Secant1006/OpenFlops-Plus/README.md

# OpenFlops-Plus
Enhanced version of open-source gotek

[OpenFlops](https://github.com/SukkoPera/OpenFlops)

[FlashFloppy](https://github.com/keirf/flashfloppy)
