Secant1006/OpenFlops-Plus/Enclosure/Bottom.sldprt

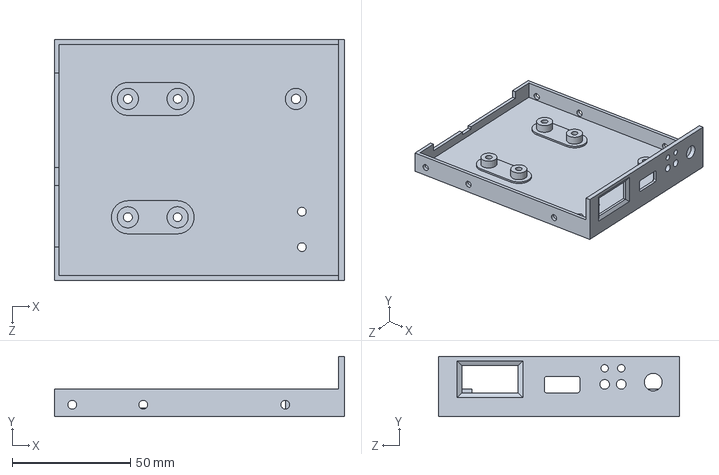
[picture p1: CAD file, 2026-06-17]
Enclosure/Bottom.sldprt
122.5 x 25.4 x 101.6 mm
