Secant1006/OpenFlops-Plus/Enclosure/Top.sldprt

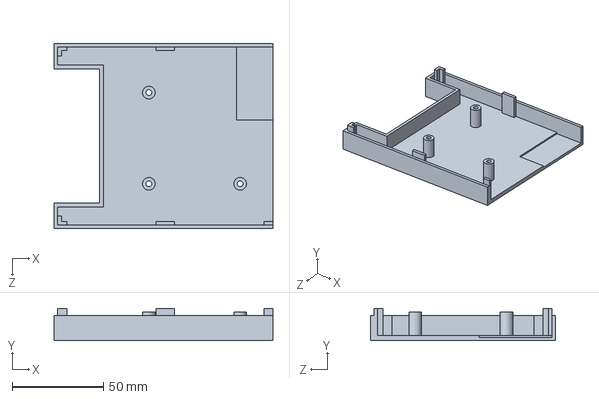
[picture p2: CAD file, 2026-06-17]
Enclosure/Top.sldprt
120.0 x 17.8 x 101.6 mm
