Secant1006/OpenFlops-Plus/Enclosure/Screen Bracket.sldprt

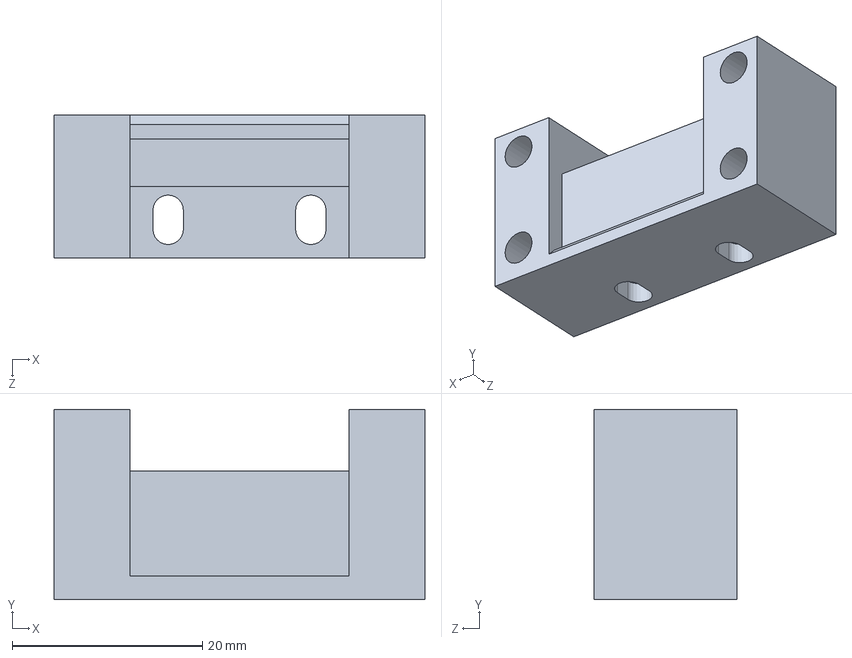
[picture p3: CAD file, 2026-06-17]
Enclosure/Screen Bracket.sldprt
39.0 x 20.0 x 15.0 mm
