Secant1006/OpenFlops-Plus/OpenFlops Plus.kicad_pcb

## KiCad design OpenFlops Plus.kicad_pcb (2026-06-24)

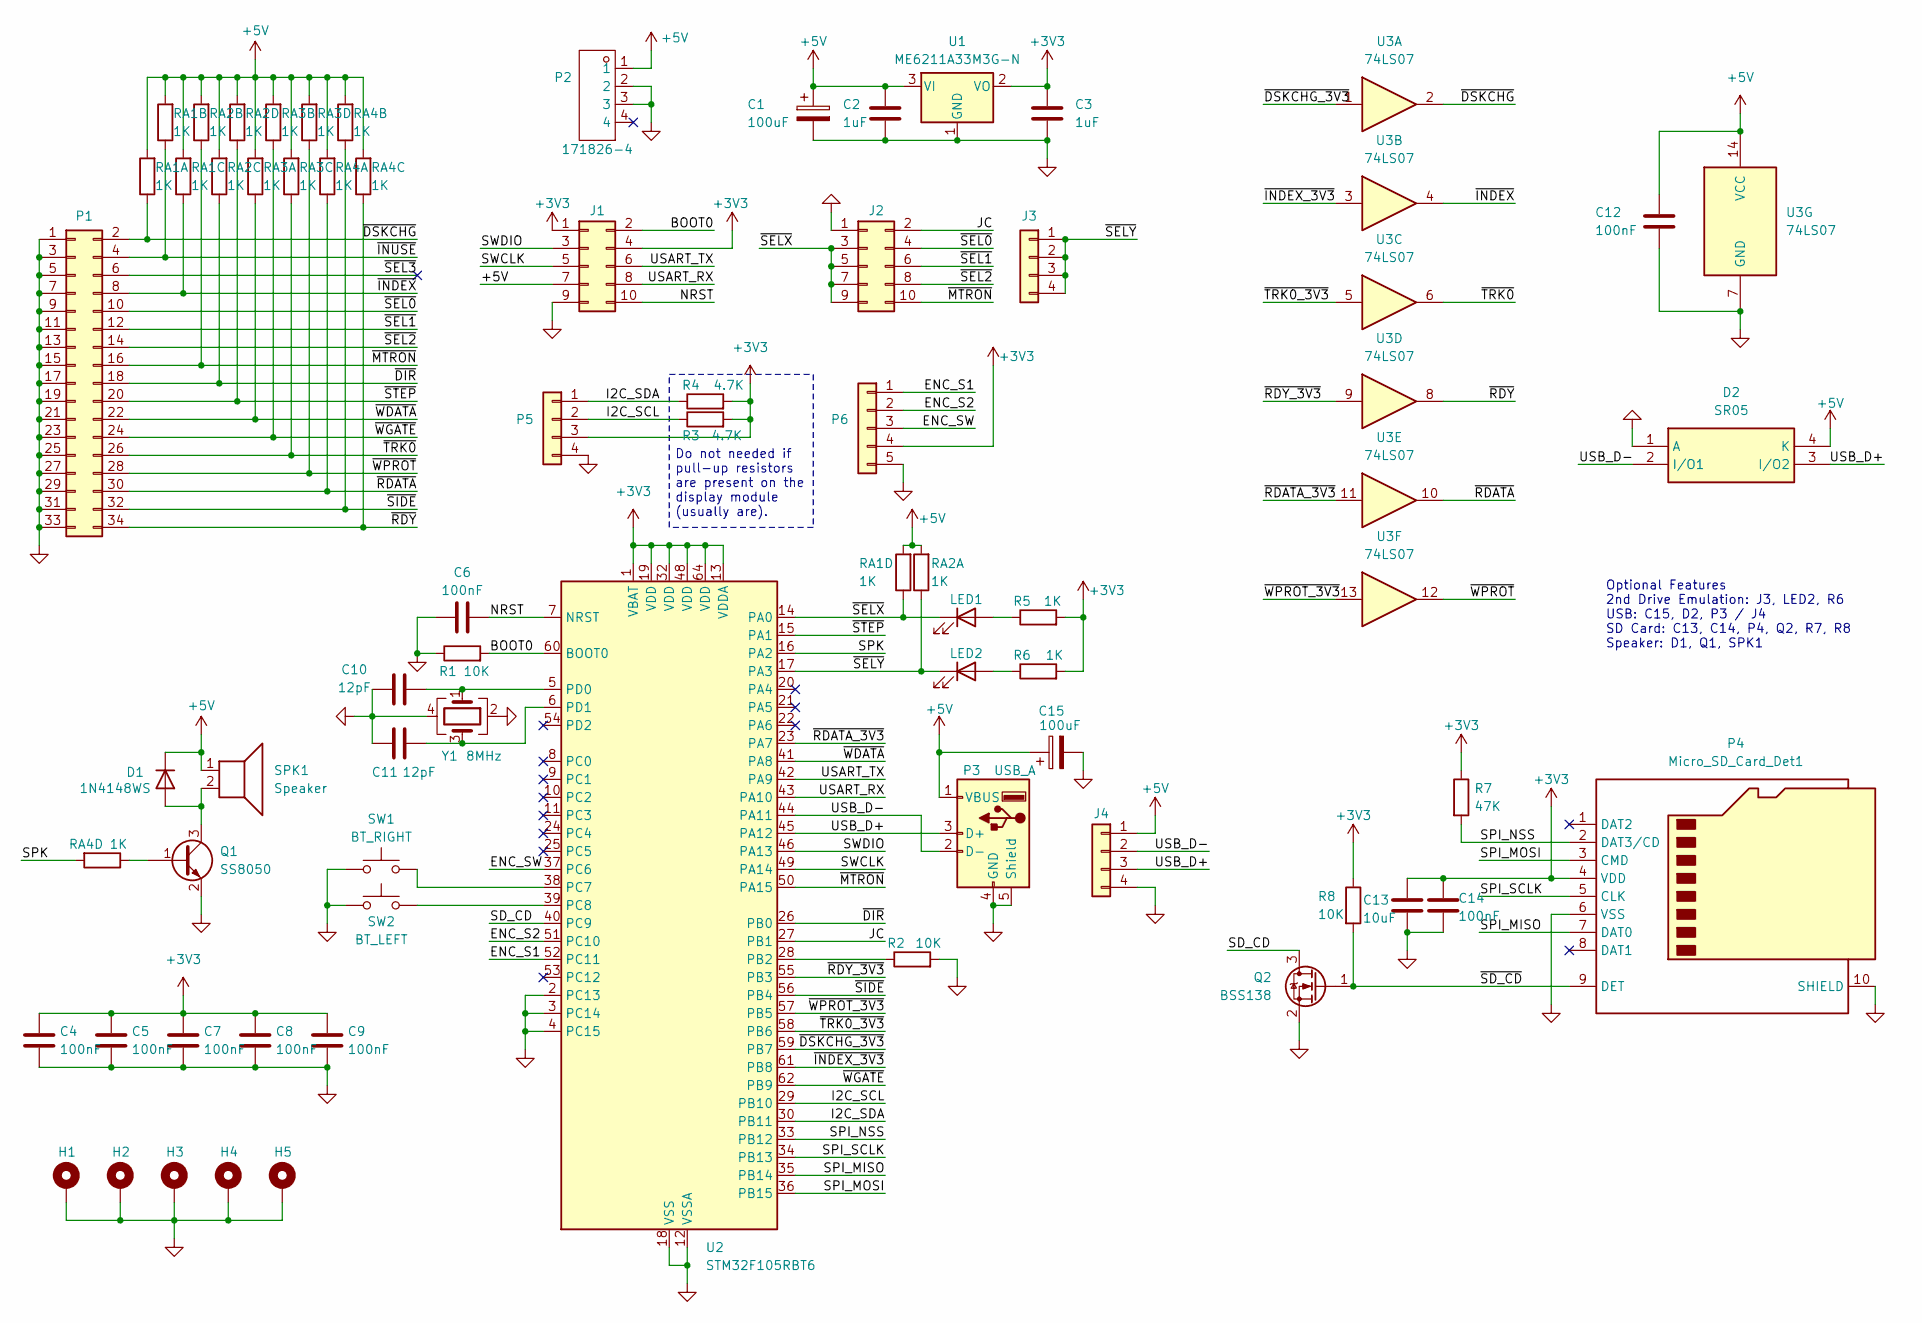
[picture p4: schematic OpenFlops Plus.kicad_sch]

Parts:
C1, C15: 100uF; CP_Radial_D6.3mm_P2.50mm
C2, C3: 1uF; C_0603_1608Metric
C4, C5, C6, C7, C8, C9, C12, C14: 100nF; C_0603_1608Metric
C10, C11: 12pF; C_0603_1608Metric
C13: 10uF; C_0805_2012Metric
D1: 1N4148WS; D_SOD-323
D2: SR05; SOT-143; Manufacturer_Part_Number SR05.TCT; Mouser Part Number 947-SR05.TCT
H1, H2, H3, H4, H5: MountingHole_Pad; MountingHole_3.2mm_M3_Pad
J1, J2: Conn_02x05_Odd_Even; PinHeader_2x05_P2.54mm_Vertical
J3, J4: Conn_01x04; PinHeader_1x04_P2.54mm_Vertical
LED1, LED2: LED; LED_D3.0mm
P1: Conn_02x17_Odd_Even; PinHeader_2x17_P2.54mm_Vertical
P2: 171826-4; CONN-TH_4P-P2.50_171826-4; Manufacturer Part 171826-4; LCSC Part Name 1x4P 间距:2.5mm 弯插
P3: USB_A; USB_A_Molex_67643_Horizontal
P4: Micro_SD_Card_Det1; TF-SMD_XKTF-015-N
P5: Conn_01x04; PinHeader_1x04_P2.54mm_Vertical
P6: Conn_01x05; PinHeader_1x05_P2.54mm_Vertical
Q1: SS8050; SOT-23
Q2: BSS138; SOT-23
R1, R2, R8: 10K; R_0603_1608Metric
R3, R4: 4.7K; R_0603_1608Metric
R5, R6: 1K; R_0603_1608Metric
R7: 47K; R_0603_1608Metric
RA1, RA2, RA3, RA4: 1K; R_Array_Convex_4x0603
SPK1: Speaker; Buzzer_12x9.5RM7.6
SW1: BT_RIGHT; SW_Tactile_SKHH_Angled
SW2: BT_LEFT; SW_Tactile_SKHH_Angled
U1: ME6211A33M3G-N; SOT-23-3
U2: STM32F105RBT6; LQFP-64_10x10mm_P0.5mm
U3: 74LS07; SOIC-14_3.9x8.7mm_P1.27mm
Y1: 8MHz; Crystal_SMD_3225-4Pin_3.2x2.5mm

Connections:
+3V3: C3.1, C4.1, C5.1, C7.1, C8.1, C9.1, C13.1, C14.1, J1.1, J1.4, P4.4 (VDD), P5.3, P6.4, R3.2, R4.2, R5.2, R6.2, R7.1, R8.1, U1.2 (VO), U2.1 (VBAT), U2.13 (VDDA), U2.19 (VDD), U2.32 (VDD), U2.48 (VDD), U2.64 (VDD)
+5V: C1.1, C2.1, C12.1, C15.1, D1.1 (K), D2.4 (K), J1.7, J4.1, P2.1, P3.1 (VBUS), RA1.5 (R4.2), RA1.6 (R3.2), RA1.7 (R2.2), RA1.8 (R1.2), RA2.5 (R4.2), RA2.6 (R3.2), RA2.7 (R2.2), RA2.8 (R1.2), RA3.5 (R4.2), RA3.6 (R3.2), RA3.7 (R2.2), RA3.8 (R1.2), RA4.6 (R3.2), RA4.7 (R2.2), RA4.8 (R1.2), SPK1.1, U1.3 (VI), U3.14 (VCC)
/BOOT0: J1.2, R1.2, U2.60 (BOOT0)
/ENC_S1: P6.1, U2.52 (PC11)
/ENC_S2: P6.2, U2.51 (PC10)
/ENC_SW: P6.3, U2.37 (PC6)
/I2C_SCL: P5.2, R3.1, U2.29 (PB10)
/I2C_SDA: P5.1, R4.1, U2.30 (PB11)
/JC: J2.2, U2.27 (PB1)
/NRST: C6.2, J1.10, U2.7 (NRST)
/SD_CD: Q2.3 (D), U2.40 (PC9)
/SPI_MISO: P4.7 (DAT0), U2.35 (PB14)
/SPI_MOSI: P4.3 (CMD), U2.36 (PB15)
/SPI_NSS: P4.2 (DAT3/CD), R7.2, U2.33 (PB12)
/SPI_SCLK: P4.5 (CLK), U2.34 (PB13)
/SPK: RA4.5 (R4.2), U2.16 (PA2)
/SWCLK: J1.5, U2.49 (PA14)
/SWDIO: J1.3, U2.46 (PA13)
/USART_RX: J1.8, U2.43 (PA10)
/USART_TX: J1.6, U2.42 (PA9)
/USB_D+: D2.3 (I/O2), J4.3, P3.3 (D+), U2.45 (PA12)
/USB_D-: D2.2 (I/O1), J4.2, P3.2 (D-), U2.44 (PA11)
/~DIR: P1.18, RA2.3 (R3.1), U2.26 (PB0)
/~DSKCHG_3V3: U2.59 (PB7), U3.1
/~DSKCHG: P1.2, RA1.1 (R1.1), U3.2
/~INDEX_3V3: U2.61 (PB8), U3.3
/~INDEX: P1.8, RA1.3 (R3.1), U3.4
/~INUSE: P1.4, RA1.2 (R2.1)
/~MTRON: J2.10, P1.16, RA2.2 (R2.1), U2.50 (PA15)
/~RDATA_3V3: U2.23 (PA7), U3.11
/~RDATA: P1.30, RA4.1 (R1.1), U3.10
/~RDY_3V3: U2.55 (PB3), U3.9
/~RDY: P1.34, RA4.3 (R3.1), U3.8
/~SD_CD: P4.9 (DET), Q2.1 (G), R8.2
/~SEL0: J2.4, P1.10
/~SEL1: J2.6, P1.12
/~SEL2: J2.8, P1.14
/~SEL3: P1.6
/~SELX: J2.3, J2.5, J2.7, J2.9, LED1.1 (K), RA1.4 (R4.1), U2.14 (PA0)
/~SELY: J3.1, J3.2, J3.3, J3.4, LED2.1 (K), RA2.1 (R1.1), U2.17 (PA3)
/~SIDE: P1.32, RA4.2 (R2.1), U2.56 (PB4)
/~STEP: P1.20, RA2.4 (R4.1), U2.15 (PA1)
/~TRK0_3V3: U2.58 (PB6), U3.5
/~TRK0: P1.26, RA3.3 (R3.1), U3.6
/~WDATA: P1.22, RA3.1 (R1.1), U2.41 (PA8)
/~WGATE: P1.24, RA3.2 (R2.1), U2.62 (PB9)
/~WPROT_3V3: U2.57 (PB5), U3.13
/~WPROT: P1.28, RA3.4 (R4.1), U3.12
GND: C1.2, C2.2, C3.2, C4.2, C5.2, C6.1, C7.2, C8.2, C9.2, C10.1, C11.1, C12.2, C13.2, C14.2, C15.2, D2.1 (A), H1.1, H2.1, H3.1, H4.1, H5.1, J1.9, J2.1, J4.4, P1.1, P1.3, P1.5, P1.7, P1.9, P1.11, P1.13, P1.15, P1.17, P1.19, P1.21, P1.23, P1.25, P1.27, P1.29, P1.31, P1.33, P2.2, P2.3, P3.4 (GND), P3.5 (Shield), P4.6 (VSS), P4.10 (SHIELD), P4.11, P4.12, P4.13, P5.4, P6.5, Q1.2 (E), Q2.2 (S), R1.1, R2.2, SW1.2, SW2.1, U1.1 (GND), U2.2 (PC13), U2.3 (PC14), U2.4 (PC15), U2.12 (VSSA), U2.18 (VSS), U2.31 (VSS), U2.47 (VSS), U2.63 (VSS), U3.7 (GND), Y1.2, Y1.4
unnamed: D1.2 (A), Q1.3 (C), SPK1.2
unnamed: LED1.2 (A), R5.1
unnamed: LED2.2 (A), R6.1
unnamed: Q1.1 (B), RA4.4 (R4.1)
unnamed: R2.1, U2.28 (PB2)
unnamed: SW1.1, U2.38 (PC7)
unnamed: SW2.2, U2.39 (PC8)
unnamed: C10.2, U2.5 (PD0), Y1.1
unnamed: C11.2, U2.6 (PD1), Y1.3

Notes on the sheet:
Do not needed if pull-up resistors are present on the display module (usually are).
Optional Features 2nd Drive Emulation: J3, LED2, R6 USB: C15, D2, P3 / J4 SD Card: C13, C14, P4, Q2, R7, R8 Speaker: D1, Q1, SPK1

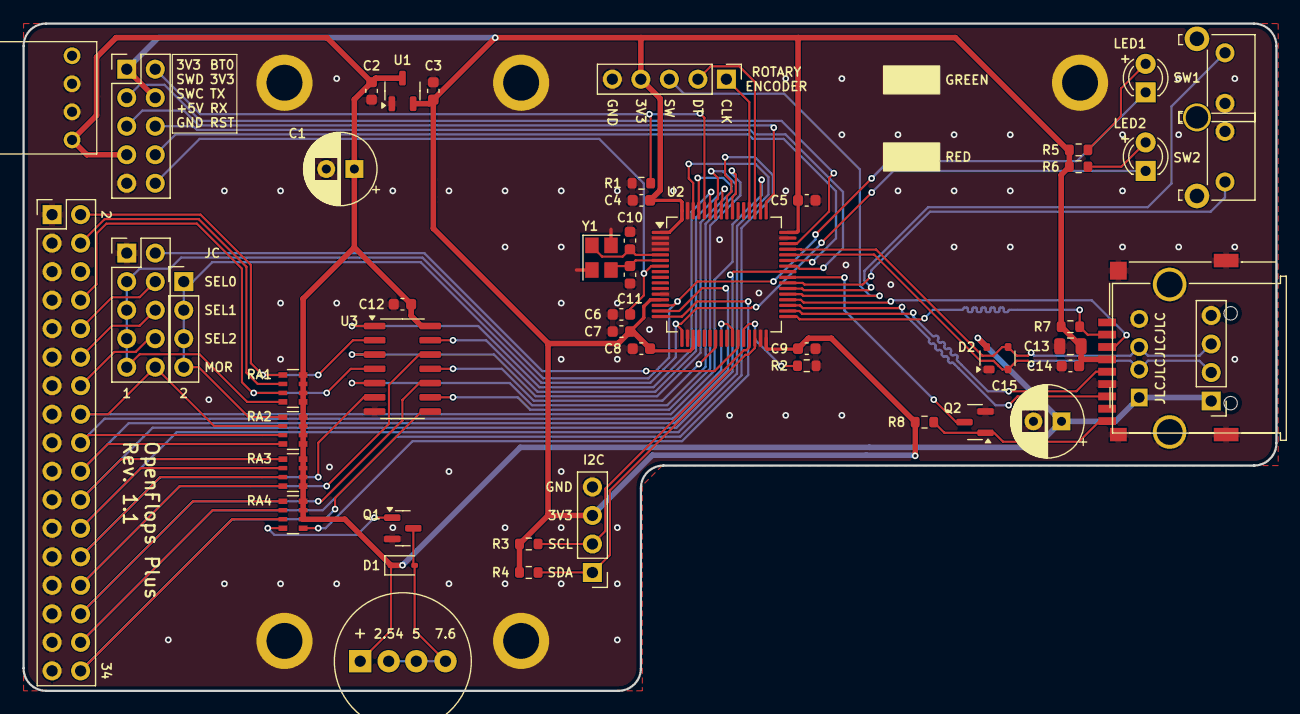
[picture p5: board OpenFlops Plus.kicad_pcb from above]

Board: 2 copper layers, 111.6 x 59.4 mm, 55 parts (0 on the bottom side), 57 nets.
