Secant1006/OpenFlops-Plus/(commit log)

2026-05-26 Release 1.0
    [OpenFlops Plus.kicad_pcb, OpenFlops Plus.kicad_sch]
2026-06-17 Add PMOS for card reader
    [Bottom.sldprt, OpenFlops Plus.kicad_pcb, OpenFlops Plus.kicad_sch, Screen Bracket.sldprt, Top.sldprt]
2026-06-21 Move to 74LS07
    [OpenFlops Plus.kicad_pcb, OpenFlops Plus.kicad_sch]
2026-06-22 Use SPI to manipulate SD card
    [OpenFlops Plus.kicad_pcb, OpenFlops Plus.kicad_sch]
2026-06-24 Update screen module
    [OpenFlops Plus.kicad_pcb, OpenFlops Plus.kicad_sch]
